NhatDang47/ball-and-beam/SCHEMATIC.pdf

# DRIVER & ENCODER POWER

# ACTUATOR

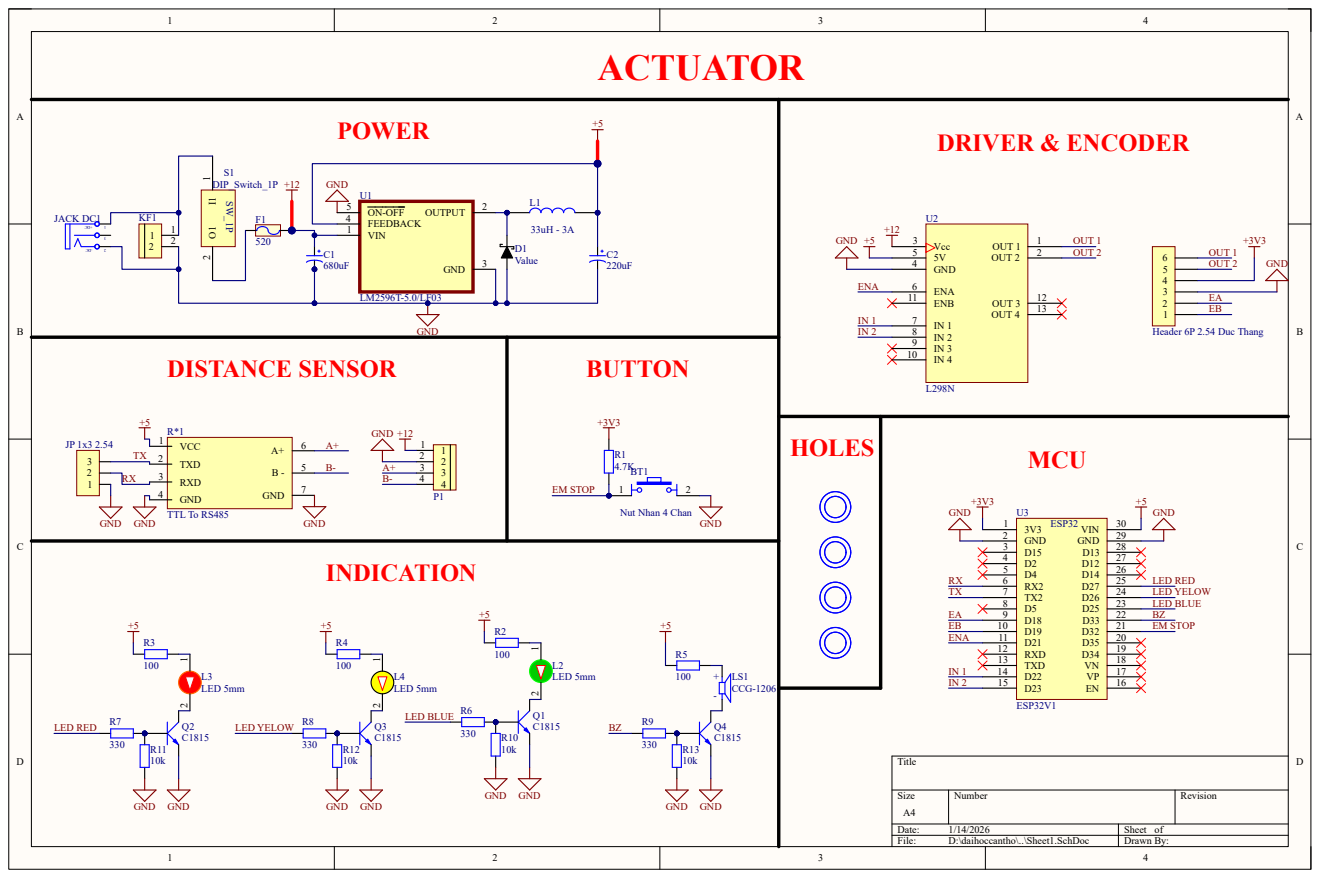
[picture p5: page 1]
